MartinCalderon-x/alexa-con-fable/docs/cobre.png

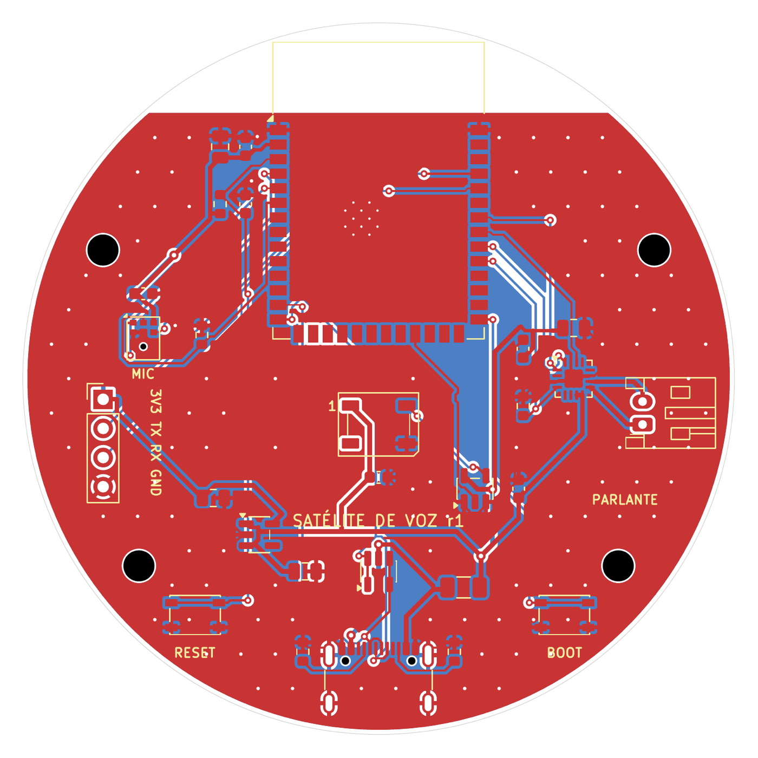
docs/cobre.png
