MartinCalderon-x/alexa-con-fable/out/fabricacion/bom.csv

Refs | Valor | Huella | MPN | Cant
C1-C3,C7 | 10u | Capacitor_SMD:C_0805_2012Metric | Murata GRM21BR61A106KE19L | 4
C4,C6,C8-C10 | 100n | Capacitor_SMD:C_0603_1608Metric | Murata GRM188R71E104KA01D | 5
C5 | 1u | Capacitor_SMD:C_0603_1608Metric | Murata GRM188R71C105KA12D | 1
D1 | WS2812B | LED_SMD:LED_WS2812B_PLCC4_5.0x5.0mm_P3.2mm | Worldsemi WS2812B | 1
F1 | 1A | Fuse:Fuse_1206_3216Metric | Littelfuse 1206L100THYR | 1
J1 | USB-C | Connector_USB:USB_C_Receptacle_GCT_USB4105-xx-A_16P_TopMnt_Horizontal | GCT USB4105-GF-A | 1
J2 | PARLANTE | Connector_JST:JST_PH_S2B-PH-K_1x02_P2.00mm_Horizontal | JST S2B-PH-K-S | 1
J3 | DEBUG | Connector_PinHeader_2.54mm:PinHeader_1x04_P2.54mm_Vertical | Harwin M20-9990446 | 1
MK1 | ICS-43434 | Sensor_Audio:InvenSense_ICS-43434-6_3.5x2.65mm | TDK InvenSense ICS-43434 | 1
R1,R2 | 5.1k | Resistor_SMD:R_0603_1608Metric | YAGEO RC0603FR-075K1L | 2
R3 | 10k | Resistor_SMD:R_0603_1608Metric | YAGEO RC0603FR-0710KL | 1
R4,R5 | 100k | Resistor_SMD:R_0603_1608Metric | YAGEO RC0603FR-07100KL | 2
SW1 | BOOT | Button_Switch_SMD:SW_SPST_PTS810 | C&K PTS810SJM250SMTRLFS | 1
SW2 | RESET | Button_Switch_SMD:SW_SPST_PTS810 | C&K PTS810SJM250SMTRLFS | 1
U1 | ESP32-S3-WROOM-1 | RF_Module:ESP32-S3-WROOM-1 | Espressif ESP32-S3-WROOM-1-N8R2 | 1
U2 | USBLC6-2SC6 | Package_TO_SOT_SMD:SOT-23-6 | ST USBLC6-2SC6 | 1
U3 | AP2112K-3.3 | Package_TO_SOT_SMD:SOT-23-5 | Diodes Inc AP2112K-3.3TRG1 | 1
U4 | MAX98357A | Package_DFN_QFN:TQFN-16-1EP_3x3mm_P0.5mm_EP1.23x1.23mm | Analog Devices MAX98357AETE+T | 1
U5 | 74AHCT1G125 | Package_TO_SOT_SMD:SOT-23-5 | TI SN74AHCT1G125DBVR | 1
