MartinCalderon-x/alexa-con-fable/out/fabricacion/placa.step

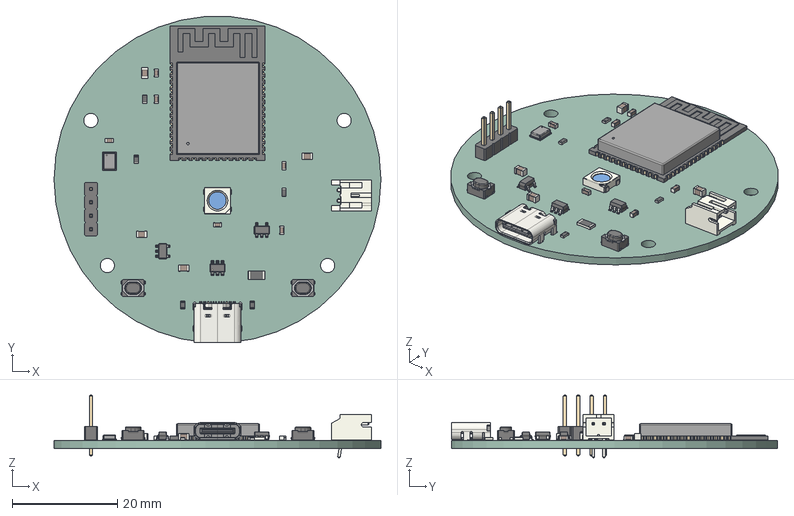
[picture p4: CAD file, 2026-11-10]
out/fabricacion/placa.step
62.0 x 61.8 x 11.9 mm
C_0603_1608Metric x 6
R_0603_1608Metric x 5
LED_WS2812B_PLCC4_50x50mm_P32mm
C_0805_2012Metric x 4
InvenSense_ICS-43434-6_3.5x2.65mm
SOT-23-6
SOT-23-5 x 2
Fuse_1206_3216Metric
ESP32-S3-WROOM-1
JST_S2B_PH_K
SW_SPST_PTS810 x 2
PinHeader_1x04_P254mm_Vertical
USB_C_Receptacle_16P_TopMnt_Horizontal_GCT_USB4105-xx-A
satelite_voz_PCB
