MartinCalderon-x/alexa-con-fable/out/fabricacion/esquema.pdf

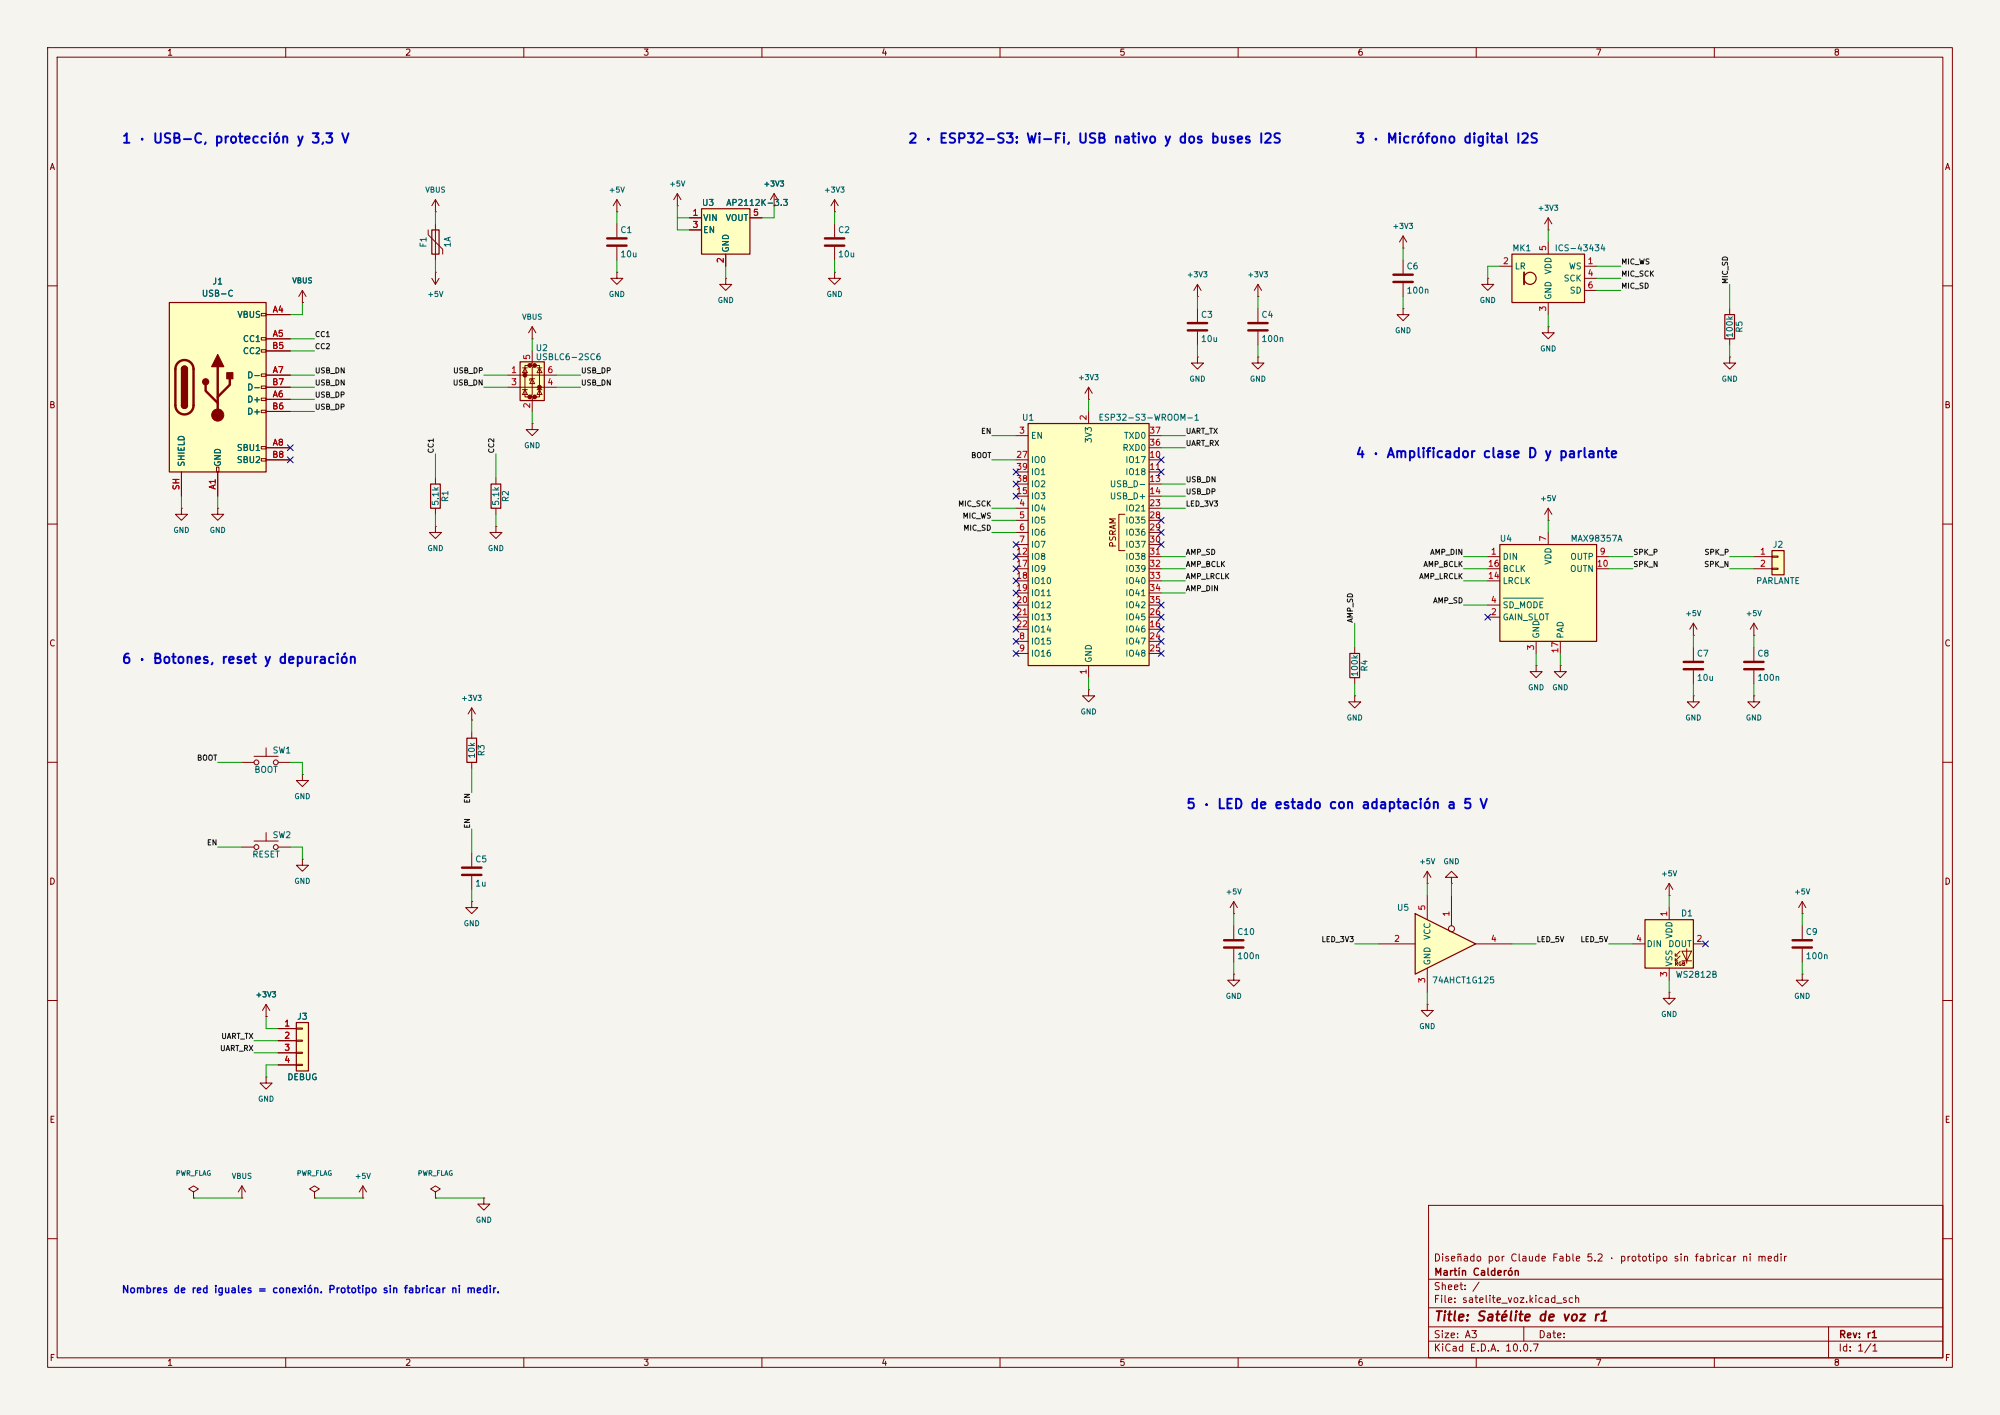
[picture p5: page 1]

5 · LED de estado con adaptación a 5 V

Diseñado por Claude Fable 5.2 · prototipo sin fabricar ni medir
Martín Calderón
Sheet: /
File: satelite_voz.kicad_sch
Title: Satélite de voz r1

Nombres de red iguales = conexión. Prototipo sin fabricar ni medir.

Size: A3 | Rev: r1 | F Date:
KiCad E.D.A. 10.0.7 | Id: 1/1
