MartinCalderon-x/alexa-con-fable/hardware/satelite_voz.kicad_pcb

## KiCad design hardware/satelite_voz.kicad_pcb (2026-11-10)

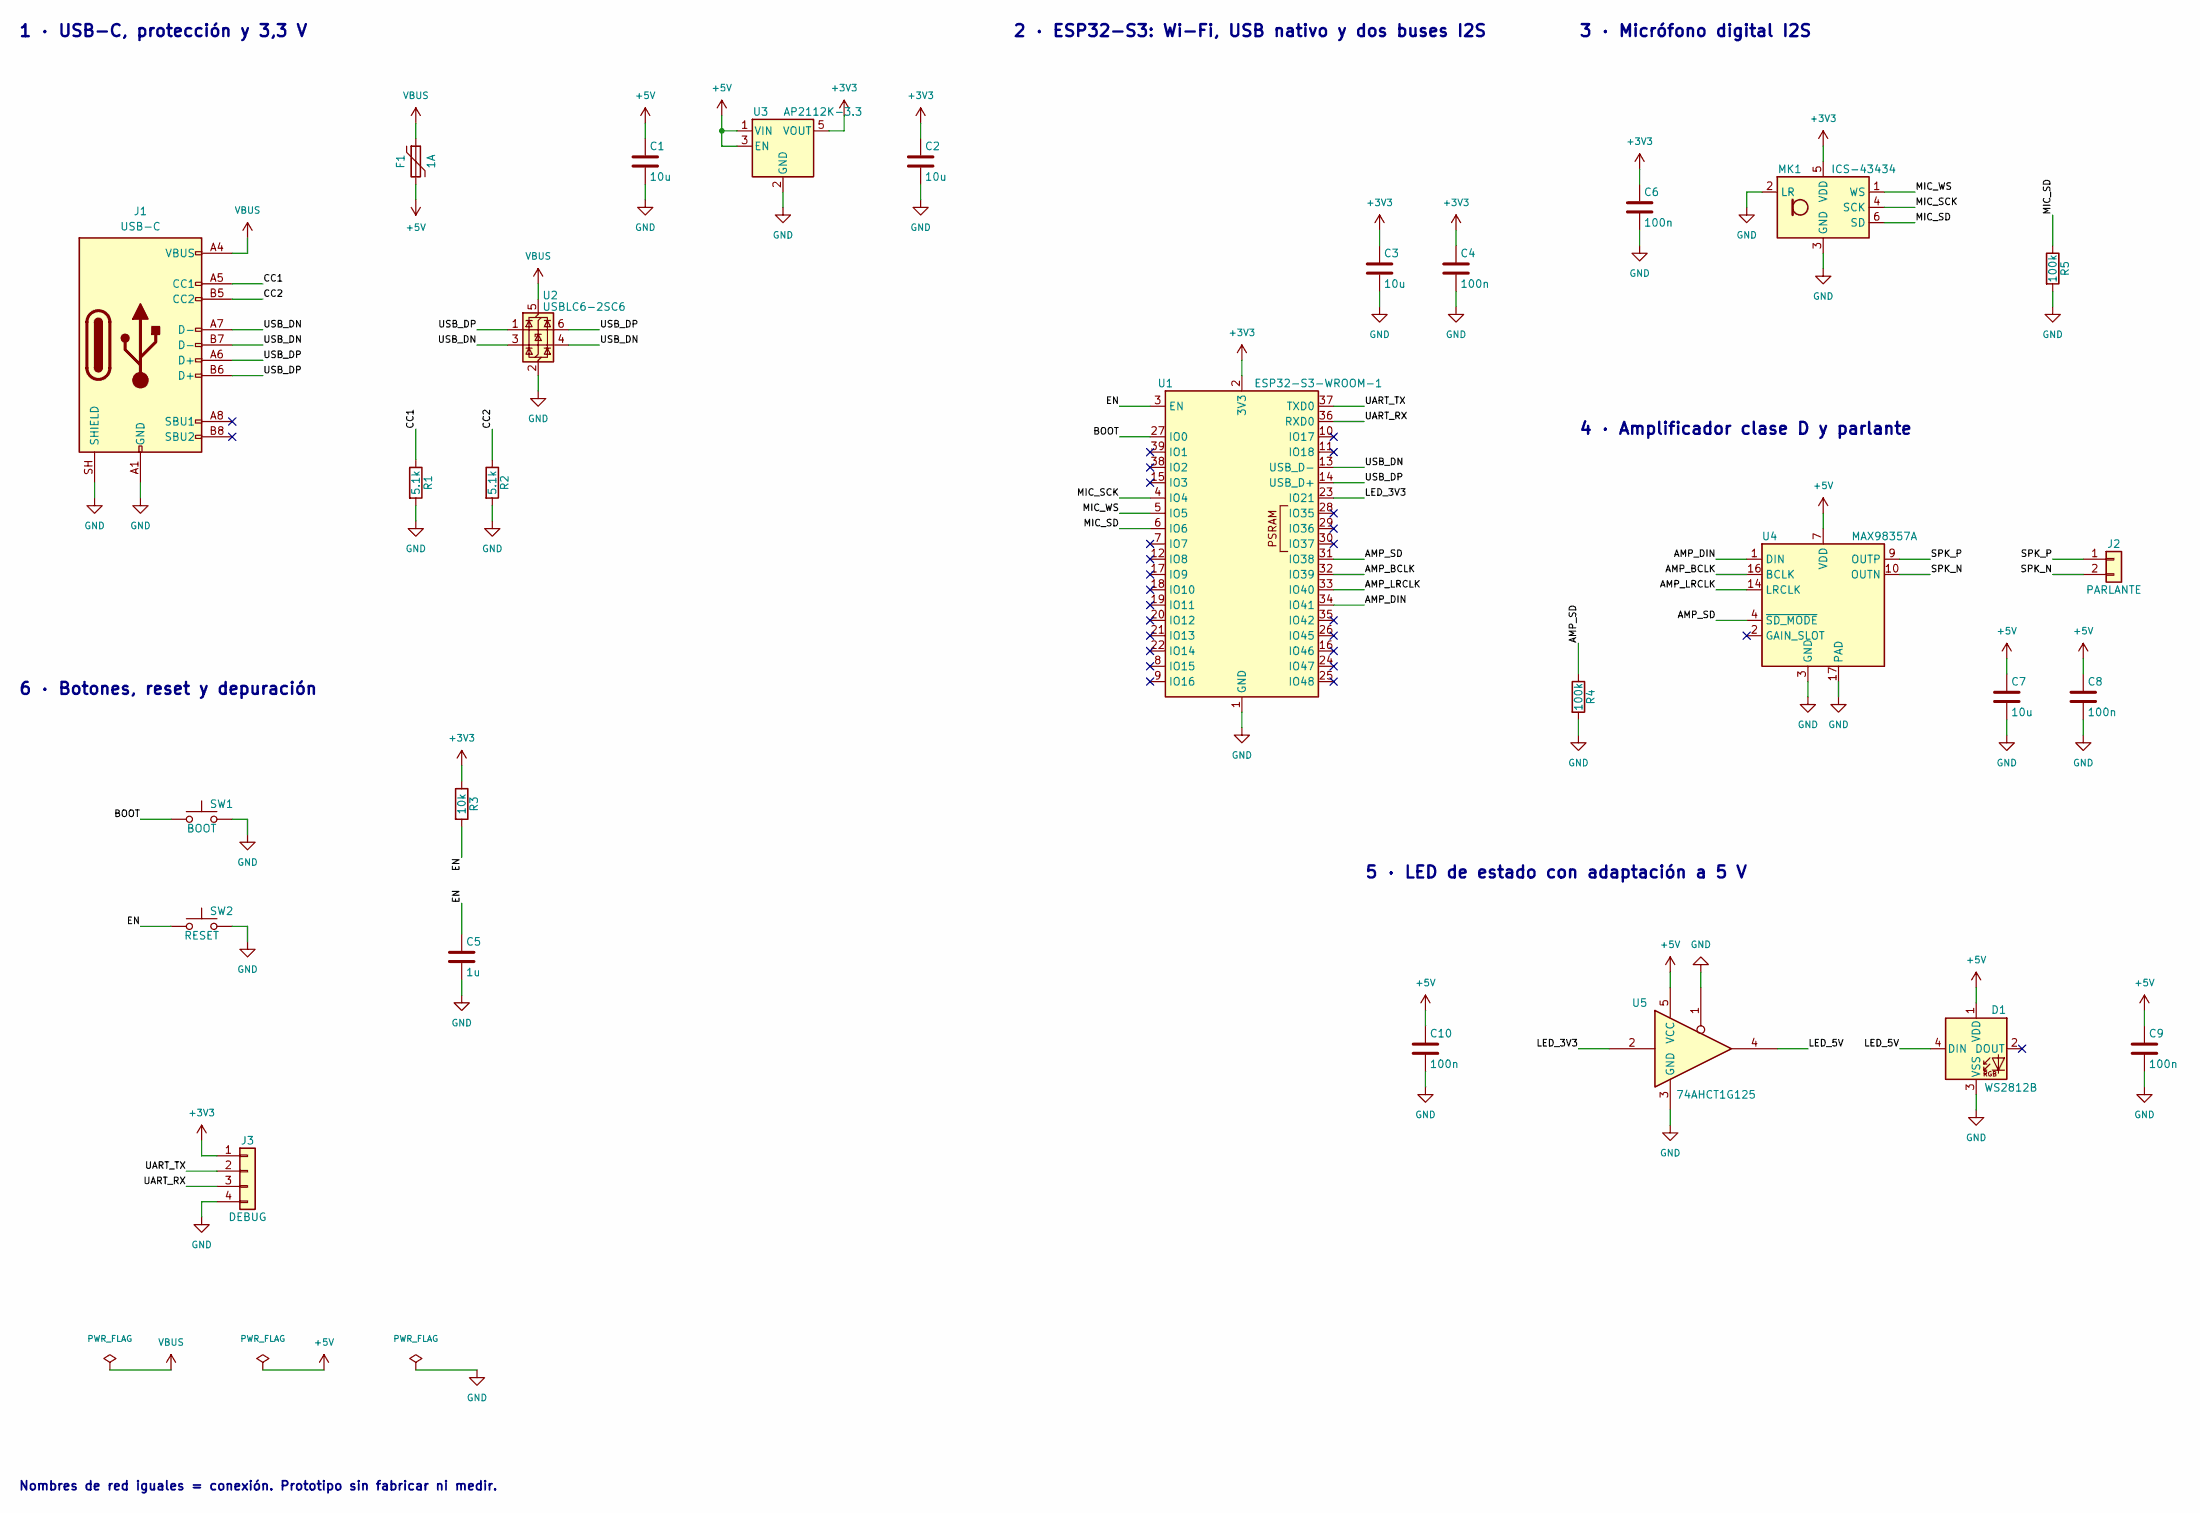
[picture p6: schematic satelite_voz.kicad_sch, Satélite de voz r1]

Parts:
C1, C2, C3, C7: 10u; C_0805_2012Metric; MPN Murata GRM21BR61A106KE19L
C4, C6, C8, C9, C10: 100n; C_0603_1608Metric; MPN Murata GRM188R71E104KA01D
C5: 1u; C_0603_1608Metric; MPN Murata GRM188R71C105KA12D
D1: WS2812B; LED_WS2812B_PLCC4_5.0x5.0mm_P3.2mm; MPN Worldsemi WS2812B
F1: 1A; Fuse_1206_3216Metric; MPN Littelfuse 1206L100THYR
J1: USB-C; USB_C_Receptacle_GCT_USB4105-xx-A_16P_TopMnt_Horizontal; MPN GCT USB4105-GF-A
J2: PARLANTE; JST_PH_S2B-PH-K_1x02_P2.00mm_Horizontal; MPN JST S2B-PH-K-S
J3: DEBUG; PinHeader_1x04_P2.54mm_Vertical; MPN Harwin M20-9990446
MK1: ICS-43434; InvenSense_ICS-43434-6_3.5x2.65mm; MPN TDK InvenSense ICS-43434
R1, R2: 5.1k; R_0603_1608Metric; MPN YAGEO RC0603FR-075K1L
R3: 10k; R_0603_1608Metric; MPN YAGEO RC0603FR-0710KL
R4, R5: 100k; R_0603_1608Metric; MPN YAGEO RC0603FR-07100KL
SW1: BOOT; SW_SPST_PTS810; MPN C&K PTS810SJM250SMTRLFS
SW2: RESET; SW_SPST_PTS810; MPN C&K PTS810SJM250SMTRLFS
U1: ESP32-S3-WROOM-1; MPN Espressif ESP32-S3-WROOM-1-N8R2
U2: USBLC6-2SC6; SOT-23-6; MPN ST USBLC6-2SC6
U3: AP2112K-3.3; SOT-23-5; MPN Diodes Inc AP2112K-3.3TRG1
U4: MAX98357A; TQFN-16-1EP_3x3mm_P0.5mm_EP1.23x1.23mm; MPN Analog Devices MAX98357AETE+T
U5: 74AHCT1G125; SOT-23-5; MPN TI SN74AHCT1G125DBVR

Connections:
+3V3: C2.1, C3.1, C4.1, C6.1, J3.1, MK1.5 (VDD), R3.1, U1.2 (3V3), U3.5 (VOUT)
+5V: C1.1, C7.1, C8.1, C9.1, C10.1, D1.1 (VDD), F1.2, U3.1 (VIN), U3.3 (EN), U4.7 (VDD), U4.8 (VDD), U5.5 (VCC)
/AMP_BCLK: U1.32 (IO39), U4.16 (BCLK)
/AMP_DIN: U1.34 (IO41), U4.1 (DIN)
/AMP_LRCLK: U1.33 (IO40), U4.14 (LRCLK)
/AMP_SD: R4.1, U1.31 (IO38), U4.4 (~SD_MODE)
/BOOT: SW1.1, U1.27 (IO0)
/CC1: J1.A5 (CC1), R1.1
/CC2: J1.B5 (CC2), R2.1
/EN: C5.1, R3.2, SW2.1, U1.3 (EN)
/LED_3V3: U1.23 (IO21), U5.2
/LED_5V: D1.4 (DIN), U5.4
/MIC_SCK: MK1.4 (SCK), U1.4 (IO4)
/MIC_SD: MK1.6 (SD), R5.1, U1.6 (IO6)
/MIC_WS: MK1.1 (WS), U1.5 (IO5)
/SPK_N: J2.2, U4.10 (OUTN)
/SPK_P: J2.1, U4.9 (OUTP)
/UART_RX: J3.3, U1.36 (RXD0)
/UART_TX: J3.2, U1.37 (TXD0)
/USB_DN: J1.A7 (D-), J1.B7 (D-), U1.13 (USB_D-), U2.3 (I/O2), U2.4 (I/O2)
/USB_DP: J1.A6 (D+), J1.B6 (D+), U1.14 (USB_D+), U2.1 (I/O1), U2.6 (I/O1)
GND: C1.2, C2.2, C3.2, C4.2, C5.2, C6.2, C7.2, C8.2, C9.2, C10.2, D1.3 (VSS), J1.A1 (GND), J1.A12 (GND), J1.B1 (GND), J1.B12 (GND), J1.SH (SHIELD), J3.4, MK1.2 (LR), MK1.3 (GND), R1.2, R2.2, R4.2, R5.2, SW1.2, SW2.2, U1.1 (GND), U1.40 (GND), U1.41 (GND), U2.2 (GND), U3.2 (GND), U4.3 (GND), U4.11 (GND), U4.15 (GND), U4.17 (PAD), U5.1, U5.3 (GND)
VBUS: F1.1, J1.A4 (VBUS), J1.A9 (VBUS), J1.B4 (VBUS), J1.B9 (VBUS), U2.5 (VBUS)

Notes on the sheet:
1 · USB-C, protección y 3,3 V
2 · ESP32-S3: Wi-Fi, USB nativo y dos buses I2S
3 · Micrófono digital I2S
4 · Amplificador clase D y parlante
5 · LED de estado con adaptación a 5 V
6 · Botones, reset y depuración
Nombres de red iguales = conexión. Prototipo sin fabricar ni medir.

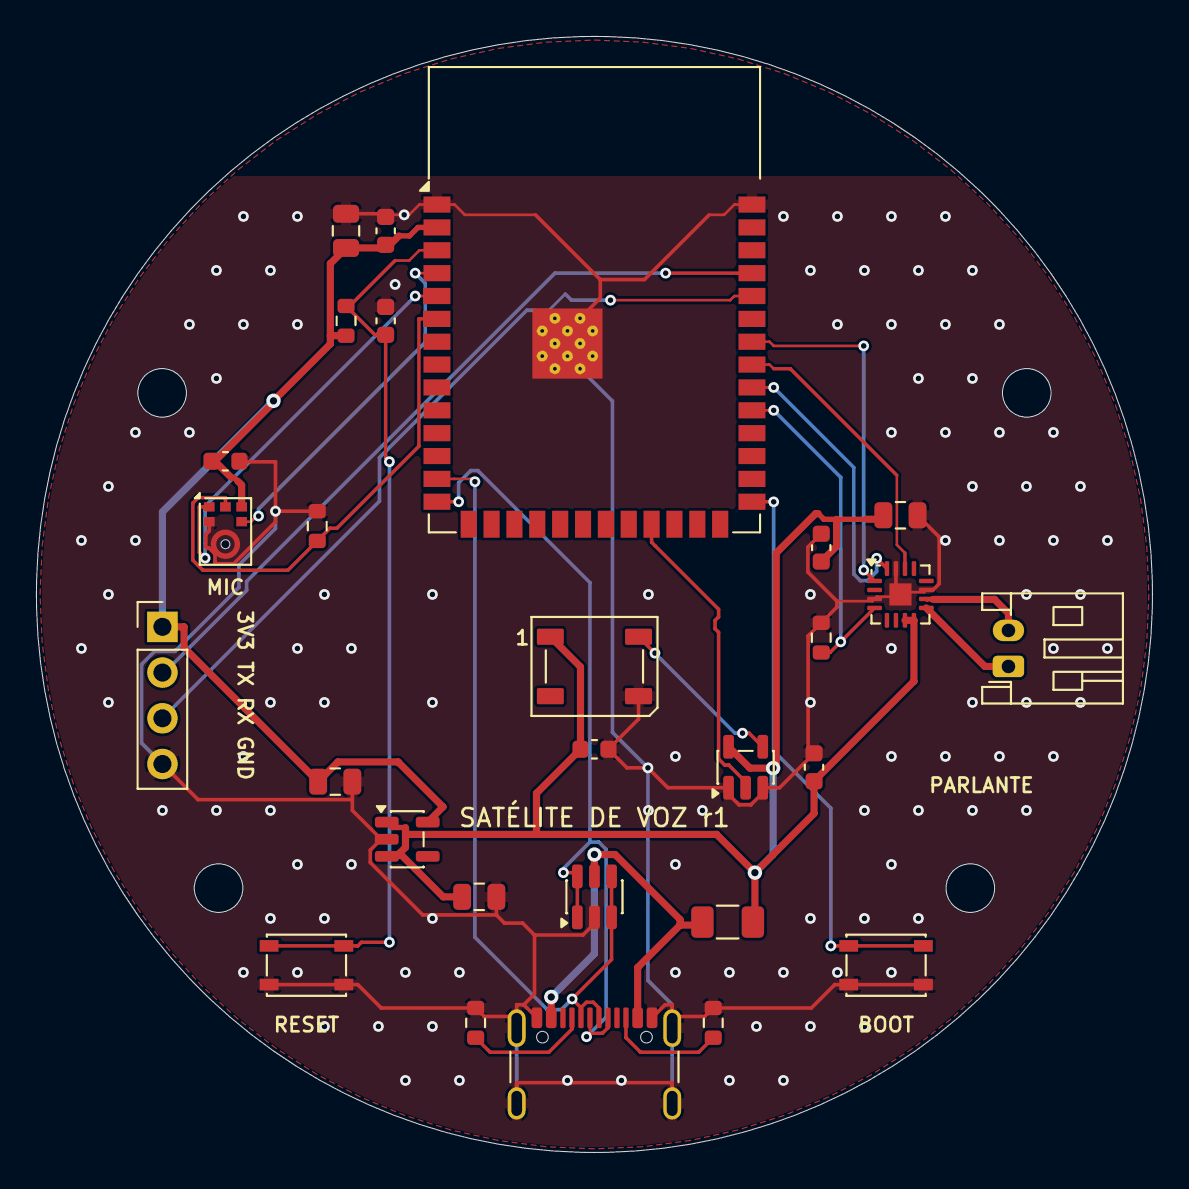
[picture p7: board satelite_voz.kicad_pcb from above]

Board: 2 copper layers, 62.0 x 62.0 mm, 32 parts (0 on the bottom side), 23 nets.

Other parts of the board:
H1, H2, H3, H4: MountingHole_2.7mm_M2.5
