MartinCalderon-x/alexa-con-fable/(commit log)

2026-11-10 feat: voice satellite r1 board, KiCad project, power bench and fabrication files
    [bom.csv, placa.step, posiciones.csv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]
2026-11-12 docs: add CERN-OHL-P v2 license and ignore KiCad lock files
